yourithetiger/Ibus-RPI/README.md

# Ibus-RPI

The goal of this project is to use a RaspBerryPi in my e39 as a addon to the OEM on board monitor. It will keep all the OEM features AND the OEM CD changer functionality while adding a lot of new features like:

- Custom Display using OEM TV av input
- Android Auto
- Bluetooth music streaming
- Many other features that I will add in the future

## How will it play audio while keeping the CD changer functionality?

The RaspBerryPi will only replace CD1 of the CD changer, the other 5 CD slots will still be available for use. The RaspBerryPi will use the CD1 slot to play audio from the Android Auto or Bluetooth streaming.

## Hardware

- RaspBerryPi 4
- Wemos D1 board (ESP8266)
- Some relays to switch the CD changer between the RaspBerryPi and the OEM CD changer

## Software

- Based on Raspbian OS
- Hudiy for the UI (<https://hudiy.eu/>) because I dont want to loose time on UI development and all the Carplay/Android Auto integration. I want to focus on the features and the integration with the car but I will probably change in the future if I find something better or if I want to develop my own UI.

## Status

- I just started the project so it's still messy and not fully functional and that's why I dont provide any instructions on how to use it yet but I will update the README as I progress and I will provide instructions on how to use it and how to install it in your car if you want to do it yourself.
- For now, I'm mainly using this repo as a place to store my code and my progress and to share it with the community but I will try to make it more organized and more user-friendly in the future.
- It will be messy and not fully functional for a while
- It will probably take me a few months to make it fully functional and to add all the features that I want to add

## My car

- BMW E39 528I touring built in july 1999 (pre-facelift)
- Full OEM on board monitor with TV av input and CD changer and navigation
- Hi-Fi audio without DSP

## More info

- If your interested in the project and want to follow the progress or if you have any questions or suggestions, feel free to contact me on my instagram @slowtouge_racer or on my discord (still in making but you can write me on it) : <https://discord.gg/TAAp7jkGBY>
- I will reply to everyone and I will try to answer all your questions and take all your suggestions into consideration.
- About me : I'm a dev student and a car enthusiast. I'm working part-time too so I dont have a lot of time that's why the project is progressing slowly but I will try to update it as much as I can. I have a lot of ideas for features and improvements but I want to focus on the basics first and make sure that the core functionality is working before adding more features.

## Copyright - license and stuff

- Keep in mind that this project is not a simple copy of any existing project, but i will take inspiration from other projects. I made this project because my goal is very specific and no existing project that I found online was doing exactly what I wanted to do.
- I will try to give credits to any project that I take inspiration from
- As I'm in the early stages of the project, I haven't decided yet on the license that I will use because I dont really know how license and stuff works and I don't have time to research about it right now.
- For now, This is NOT a commercial project and I have NO intention to make money from it. I just want to share my work and my progress with the community and maybe help some people who want to do something similar in their cars.
- If you think that I made an unathorized use of your work or if you have any concerns about the project, please contact me and I will try to resolve the issue as soon as possible. I want this project to be open and collaborative and I will try to respect the work of others as much as I can.
