yourithetiger/Ibus-RPI/pi4-HAT/fab/pi4-HAT-BOM-JLCPCB-OPTIMIZED.csv

Comment | Designator | Footprint | LCSC Part #
100nF | C1,C3,C5,C11,C14,C16,C22,C23,C25,C27 | C_0603_1608Metric | C14663
10uF | C2 | C_1206_3216Metric | C13585
47uF | C4 | C_1206_3216Metric | C96937
22uF | C6,C7 | C_0805_2012Metric | C45783
220pF | C9 | C_0603_1608Metric | C1600
10uF | C10,C15,C19,C20,C24,C26,C30,C31,C32,C33 | C_0805_2012Metric | C15850
2.2uF | C12,C13 | C_0603_1608Metric | C23630
2.2nF | C17,C18 | C_0603_1608Metric | C1591
10uF | C21 | C_0603_1608Metric | C19702
1uF | C28,C29 | C_0603_1608Metric | C15849
BAT54C | D3,D9,D11 | SOT-23 | C8596
GREEN | D4 | LED_0805_2012Metric | C2297
BLUE | D5 | LED_0805_2012Metric | C2293
1N4148 | D7,D10 | D_SOD-323 | C81598
BZX84C3V3 | D8 | SOT-23 | C8675
120R/2A | FB1,FB2,FB3 | L_0805_2012Metric | C1015
BLM21PG221SN1D | L2 | L_0805_2012Metric | C1035
2N7002 | Q1,Q2,Q3,Q5,Q6 | SOT-23 | C8598
DMP32D4S | Q4 | SOT-23 | C151273
3.9k | R1,R2 | R_0603_1608Metric | C22985
100k | R3,R16,R24,R25,R26,R35,R36,R40,R42 | R_0603_1608Metric | C25803
1k | R5,R8,R10,R13,R14,R39,R41 | R_0603_1608Metric | C21190
1M | R6,R29,R30 | R_0603_1608Metric | C22935
10 | R7 | R_1206_3216Metric | C17935
2k | R9,R11 | R_0603_1608Metric | C21198
10k | R12 | R_0805_2012Metric | C17414
470 | R17,R18 | R_0603_1608Metric | C23179
10k | R19,R22,R37,R43 | R_0603_1608Metric | C25804
3.3k | R23 | R_0603_1608Metric | C22978
100 | R27,R44 | R_0603_1608Metric | C22775
680k | R28 | R_0603_1608Metric | C23206
10M | R34 | R_0603_1608Metric | C125141
20k | R38 | R_0603_1608Metric | C25760
2.2k | R45 | R_0603_1608Metric | C21199
CAT24C256 | U1 | SOIC-8_3.9x4.9mm_P1.27mm | C146734
TPS54302 | U3 | SOT-23-6 | C311983
PCM5122PW | U4 | TSSOP-28_4.4x9.7mm_P0.65mm | C962071
TS5A3159 | U5 | SOT-23-6 | C92485
PAM8406D | U7 | SOIC-16_3.9x9.9mm_P1.27mm | C86270
