yourithetiger/Ibus-RPI/(list of files, drawings)

Other design files:
pi4-HAT/pi4-HAT.dsn
