yourithetiger/Ibus-RPI/pi4-HAT/pi4-HAT.kicad_pcb

## KiCad design pi4-HAT/pi4-HAT.kicad_pcb (2026-10-29)

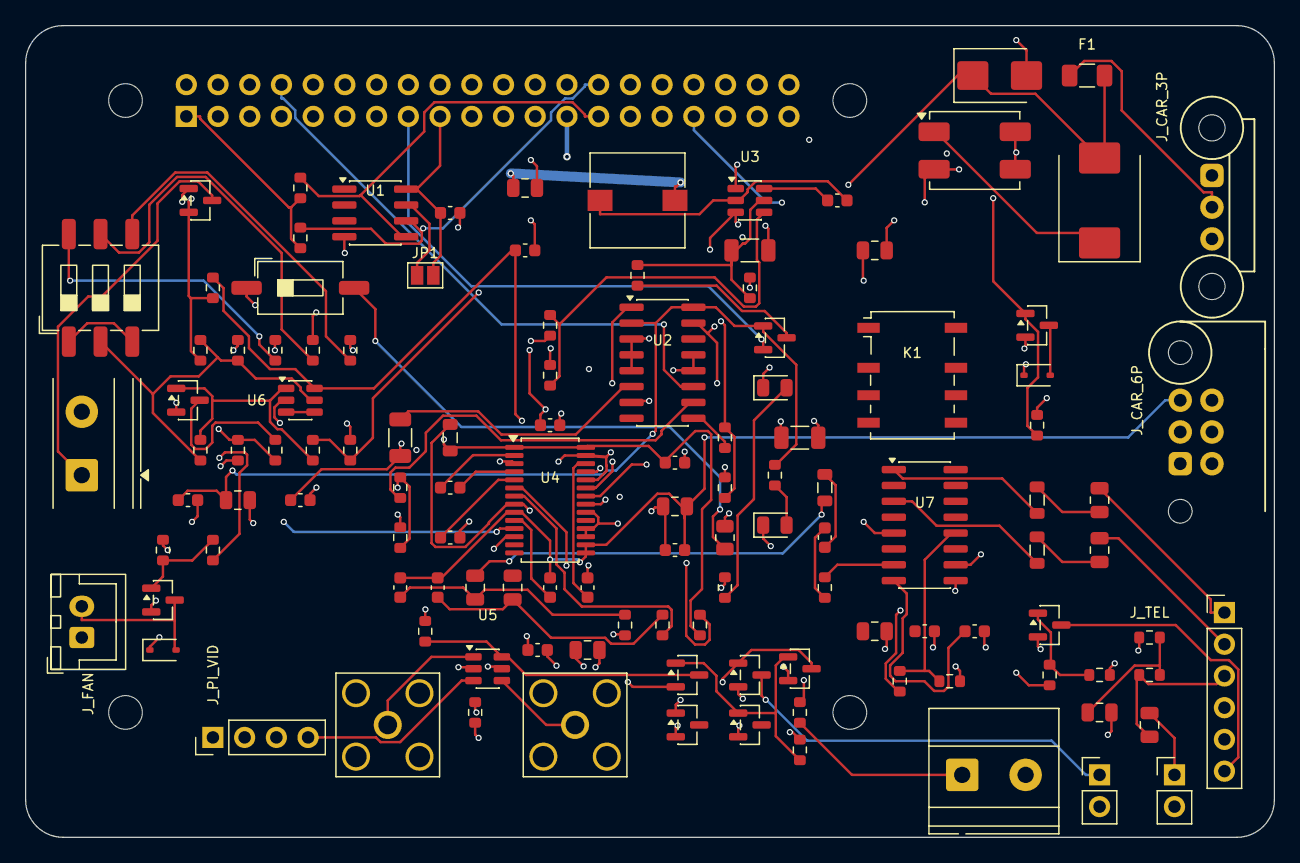
[picture p1: board pi4-HAT.kicad_pcb from above]

Board: 4 copper layers, 100.0 x 65.0 mm, 125 parts (1 on the bottom side), 91 nets.

Parts:
C1: 100n; C_0603_1608Metric
C2: 10uF_50V; C_1206_3216Metric
C3, C5, C11, C14, C16, C22, C23, C25: 100nF; C_0603_1608Metric
C4: 47uF; C_1206_3216Metric
C6, C7: 22uF; C_0805_2012Metric
C9: 220pF; C_0603_1608Metric
C10, C15, C19, C20, C24, C26, C30, C31, C32, C33: 10uF; C_0805_2012Metric
C12, C13: 2.2uF; C_0603_1608Metric
C17, C18: 2.2nF; C_0603_1608Metric
C21: 10uF; C_0603_1608Metric
C27: 0.1uF; C_0603_1608Metric
C28, C29: 1uF; C_0603_1608Metric
D1: SMBJ18A; D_SMB
D2: SS34; D_SMC
D3, D9, D11: BAT54C; SOT-23
D4: GREEN; LED_0805_2012Metric
D5: BLUE; LED_0805_2012Metric
D7, D10: 1N4148; D_SOD-323
D8: BZX84C3V3; SOT-23
D12: BZX84C4V7; SOT-23
F1: 5A; Fuse_1206_3216Metric
FB1, FB2, FB3: 120R/2A; L_0805_2012Metric
FL1: ACM70V-701-2PL; L_CommonModeChoke_TDK_ACM7060
J1: GPIO; PinSocket_2x20_P2.54mm_Vertical
JP1: ID_WP; SolderJumper-2_P1.3mm_Open_Pad1.0x1.5mm
J_CAR_3P: TE_953442-1; TE_MQS_3PIN
J_CAR_6P: TE_966871-1; TE_MQS_6PIN
J_DVR: TE_MKDS_2P; TerminalBlock_Phoenix_MKDS-1,5-2-5.08_1x02_P5.08mm_Horizont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
J_FAN: JST_2P_FAN; JST_XH_B2B-XH-A_1x02_P2.50mm_Vertical
J_MIC: MIC_OUT_USB; PinHeader_1x02_P2.54mm_Vertical
J_PI_VID: TRRS_3.5mm_PI; PinHeader_1x04_P2.54mm_Vertical
J_RCA_CAM: RCA_CAM_IN; SMA_Amphenol_132203-12_Horizontal
J_RCA_TV: RCA_TV_OUT; SMA_Amphenol_132203-12_Horizontal
J_REV: MKDS_REV_12V; TerminalBlock_Phoenix_MKDS-1,5-2-5.08_1x02_P5.08mm_Horizont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
J_TEL: TCU_IO_DB25; PinHeader_1x06_P2.54mm_Vertical
J_TV_TRIG: TV_PIN17_TRIG; PinHeader_1x02_P2.54mm_Vertical
K1: G6K-2F-Y-5VDC; Relay_DPDT_Omron_G6K-2F-Y
L1: 10uH; L_Wuerth_WE-PD-Typ-7345
L2: BLM21PG221SN1D; L_0805_2012Metric
MH1, MH2, MH3, MH4: MountingHole_2.7mm_M2.5
Q1, Q2, Q3, Q5, Q6: 2N7002; SOT-23
Q4: DMP32D4S; SOT-23
R1, R2: 3.9k; R_0603_1608Metric
R3: 100k_1%; R_0603_1608Metric
R4: 13.3k_1%; R_0603_1608Metric
R5, R8, R10, R13, R14, R39, R41: 1k; R_0603_1608Metric
R6: 1M; R_0603_1608Metric
R7: 10_1W; R_1206_3216Metric
R9, R11: 2k; R_0603_1608Metric
R12: 10k; R_0805_2012Metric
R16, R24, R25, R26, R35, R36, R40, R42: 100k; R_0603_1608Metric
R17, R18: 470; R_0603_1608Metric
R19, R22, R37, R43: 10k; R_0603_1608Metric
R23: 3.3k; R_0603_1608Metric
R27, R44: 100; R_0603_1608Metric
R28: 680k; R_0603_1608Metric
R29: 1.00M_1%; R_0603_1608Metric
R30: 1.00M; R_0603_1608Metric
R31: 118k_1%; R_0603_1608Metric
R32: 115k_1%; R_0603_1608Metric
R33: 113k_1%; R_0603_1608Metric
R34: 10M; R_0603_1608Metric
R38: 20k; R_0603_1608Metric
R45: 2.2k; R_0603_1608Metric
SW_BENCH: SW_BENCH; SW_DIP_SPSTx01_Slide_6.7x4.1mm_W8.61mm_P2.54mm_LowProfile
SW_DVR_CFG: DIP-3; SW_DIP_SPSTx03_Slide_6.7x9.18mm_W8.61mm_P2.54mm_LowProfile
U1: CAT24C256; SOIC-8_3.9x4.9mm_P1.27mm
U2: TH3122.4; SOIC-16_3.9x9.9mm_P1.27mm
U3: TPS54302; SOT-23-6
U4: PCM5122PW; TSSOP-28_4.4x9.7mm_P0.65mm
U5: TS5A3159; SOT-23-6
U6: TLV3012; SOT-23-6
U7: PAM8406D; SOIC-16_3.9x9.9mm_P1.27mm

Connections:
+3V3: C1.1, C14.1, J1.1, J1.17, JP1.2, L2.1, R1.1, R2.1, R19.1, U1.8, U4.1, U4.28
+5V: C6.1, C7.1, C23.1, C24.1, D7.1, D10.1, J1.2, J1.4, J_FAN.1, L1.2, R3.1, R13.2, R44.1, U5.5, U7.5, U7.9
+12V_IN: C2.1, C3.1, FL1.2, SW_BENCH.1, U2.1, U2.15, U3.3
AGND: C15.2, C16.2, C17.2, C18.2, C21.2, J_CAR_6P.3, J_CAR_6P.6, U4.9, U4.15, U4.16
AVDD_3V3: C15.1, C16.1, L2.2, U4.8
BENCH_PULLUP: R12.1, SW_BENCH.2
BOOT_NODE: C5.1, U3.6
BUCK_EN: C4.1, R5.2, R6.1, U3.5
BUCK_FB: R3.2, R4.1, U3.4
CAM_TRIG_GND: J_TV_TRIG.1, Q2.3
CAM_VID: J_RCA_CAM.1, U5.1
DAC_CAPM: C12.2, U4.4
DAC_CAPP: C12.1, U4.2
DAC_FLT_L: C17.1, C19.1, R17.2
DAC_FLT_R: C18.1, C20.1, R18.2
DAC_LDOO: C22.1, U4.26
DAC_OUTL_RAW: R17.1, U4.6
DAC_OUTR_RAW: R18.1, U4.7
DAC_VCOM: C21.1, U4.10
DAC_VNEG: C13.1, U4.5
DAC_XSMT: R19.2, U4.25
DVR_12V_OUT: J_DVR.1, Q4.3
DVR_COMP_OUT: Q3.1, R34.2, R37.1, U6.1
DVR_GATE_PULL: Q3.3, R36.2
DVR_PMOS_GATE: Q4.1, R35.2, R36.1
DVR_SENSE: R29.2, R30.1, R34.1, SW_DVR_CFG.2, U6.5
DVR_VCC_5V: C25.1, D12.1, R28.2, U6.6
FAN_GATE: Q5.1, R26.1, R27.2
FAN_NEG: D10.2, J_FAN.2, Q5.3
GND: C1.2, C2.2, C3.2, C4.2, C6.2, C7.2, C9.2, C10.2, C11.2, C13.2, C14.2, C22.2, C23.2, C24.2, C25.2, C26.2, C27.2, C28.2, C32.2, D1.2, D4.1, D5.1, D8.2, D12.2, FL1.3, FL1.4, J1.6, J1.9, J1.14, J1.20, J1.25, J1.30, J1.34, J1.39, J_CAR_3P.1, J_DVR.2, J_MIC.2, J_PI_VID.3, J_RCA_CAM.2, J_RCA_TV.2, J_REV.2, J_TEL.4, J_TV_TRIG.2, Q1.2, Q2.2, Q3.2, Q5.2, Q6.2, R4.2, R6.2, R9.2, R11.2, R16.2, R23.2, R24.2, R25.2, R26.2, R30.2, R31.2, R32.2, R33.2, R38.2, R40.2, R42.2, U1.4, U2.3, U2.4, U2.5, U2.7, U2.12, U2.13, U3.1, U4.3, U4.17, U4.18, U4.20, U4.24, U4.27, U5.2, U6.2, U7.10
GPIO2/SDA1: J1.3, U4.11
GPIO3/SCL1: J1.5, U4.12
GPIO12/PWM0: J1.32, R27.1
GPIO13/PWM1: J1.33, R22.2
GPIO14/TXD0: J1.8, U2.11
GPIO15/RXD0: J1.10, R8.2, R9.1
GPIO16: J1.36, R10.2, R11.1
GPIO17: J1.11, R41.1
GPIO18/PCM.CLK: J1.12, U4.21
GPIO19/PCM.FS: J1.35, U4.23
GPIO21/PCM.DOUT: J1.40, U4.22
GPIO22: D3.2, J1.15
GPIO23: J1.16, R39.1
GPIO24: D11.2, J1.18
GPIO25: D9.2, J1.22
GPIO26: J1.37, R37.2, R38.1
IBUS: C9.1, J_CAR_3P.3, R7.1, R12.2
IBUS_5V: C10.1, C11.1, D3.1, R14.2, U2.2, U2.16
ID_SCL: J1.28, R2.2, U1.6
ID_SDA: J1.27, R1.2, U1.5
KL30: F1.1, J_CAR_3P.2
LED_5V_ANODE: D4.2, R13.1
LED_IBUS_ANODE: D5.2, R14.1
unnamed: C28.1, U7.8
unnamed: C29.1, FB3.2
unnamed: C29.2, R43.1
unnamed: C30.1, FB1.2
unnamed: C30.2, J_TEL.1
unnamed: C31.1, FB2.2
unnamed: C31.2, J_TEL.2
unnamed: C32.1, R44.2, R45.2
unnamed: C33.1, J_TEL.3, R45.1
unnamed: C33.2, J_MIC.1
unnamed: FB1.1, U7.1
unnamed: FB2.1, U7.3
unnamed: JP1.1, U1.7
unnamed: J_TEL.6, Q6.3
unnamed: Q6.1, R39.2, R40.1
unnamed: R31.1, SW_DVR_CFG.6
unnamed: R32.1, SW_DVR_CFG.5
unnamed: R33.1, SW_DVR_CFG.4
unnamed: R41.2, R42.1, U7.12
unnamed: R43.2, U7.7
unnamed: SW_DVR_CFG.1, SW_DVR_CFG.3
unnamed: U6.3, U6.4
PI_AUDIO_L: C19.2, FB3.1
PI_VID: J_PI_VID.4, U5.3
PWR_KEEP_ALIVE: D3.3, R5.1
RELAY_COIL_NEG: D7.2, Q1.3
RELAY_CTRL: J1.13, Q1.1, R16.1
REV_12V_IN: J_REV.1, R22.1
REV_SENSE_3V3: D8.1, D9.1, D11.1, R23.1
SW_NODE: C5.2, L1.1, U3.2
TH3122_IBUS: R7.2, U2.6
TH3122_RXD: R8.1, U2.10
TH3122_SEN_STA: R10.1, U2.9
TV_TRIG_GATE: D9.3, Q2.1, R25.1
TV_VID_OUT: J_RCA_TV.1, U5.4
VFILT: D2.1, FL1.1
VID_SEL: D11.3, R24.1, U5.6
VRAW: D1.1, D2.2, F1.2, Q4.2, R28.1, R29.1, R35.1
